MMarsland/Augmented-Reality-Laparoscopic-Surgery-Trainer/images/blender-program.png

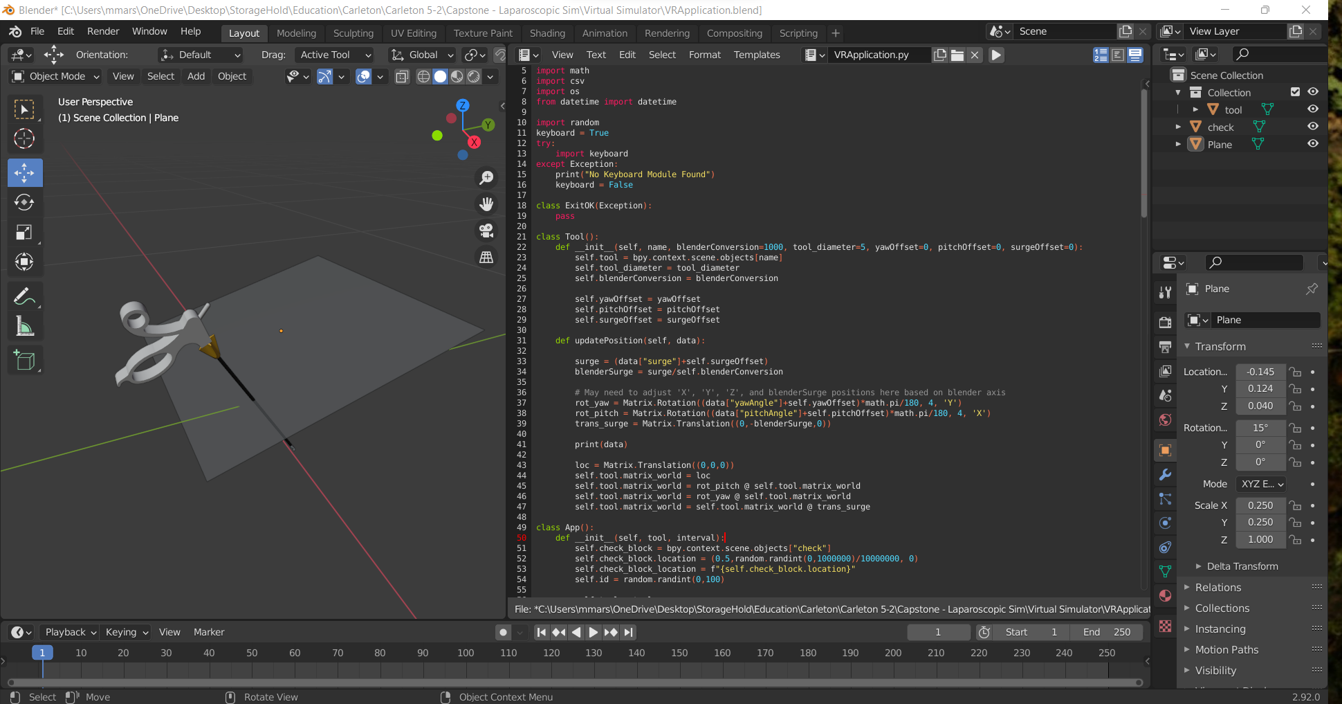
images/blender-program.png
