MMarsland/Augmented-Reality-Laparoscopic-Surgery-Trainer/images/graphs.png

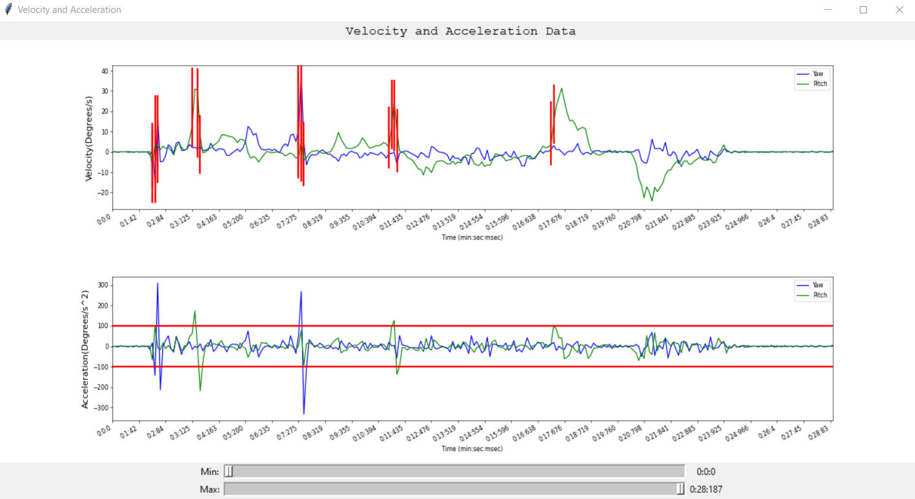
images/graphs.png
