MMarsland/Augmented-Reality-Laparoscopic-Surgery-Trainer/images/inside.jpg

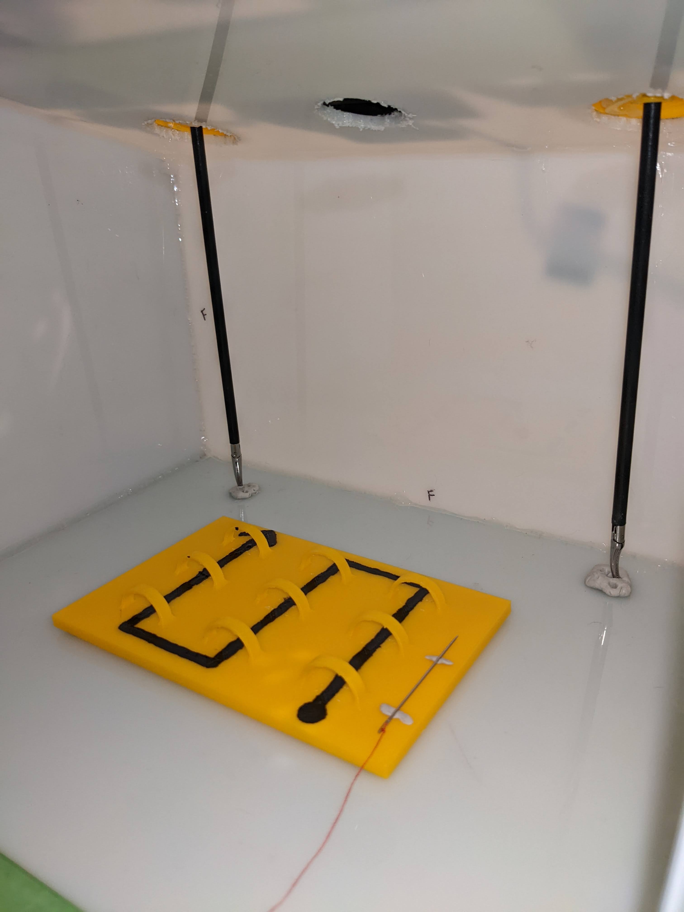
images/inside.jpg
