MMarsland/Augmented-Reality-Laparoscopic-Surgery-Trainer/images/model.png

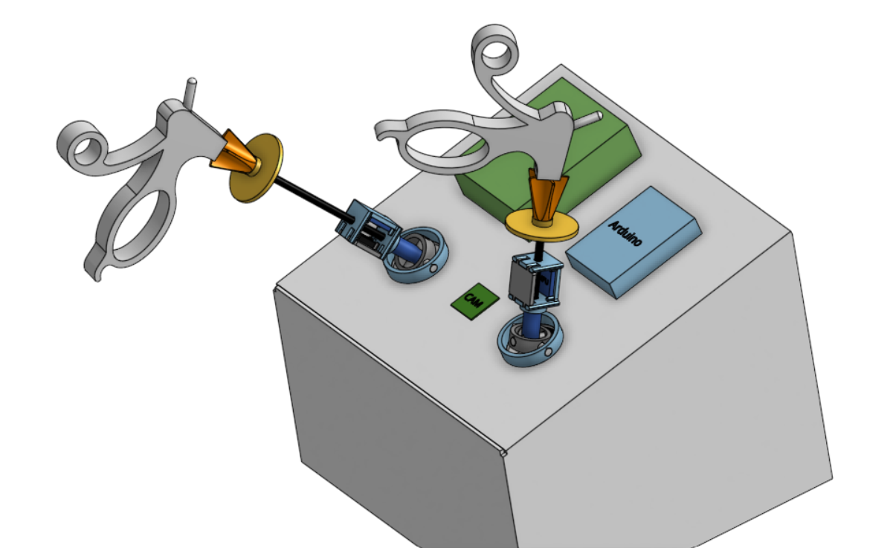
images/model.png
