MMarsland/Augmented-Reality-Laparoscopic-Surgery-Trainer/images/program-running.png

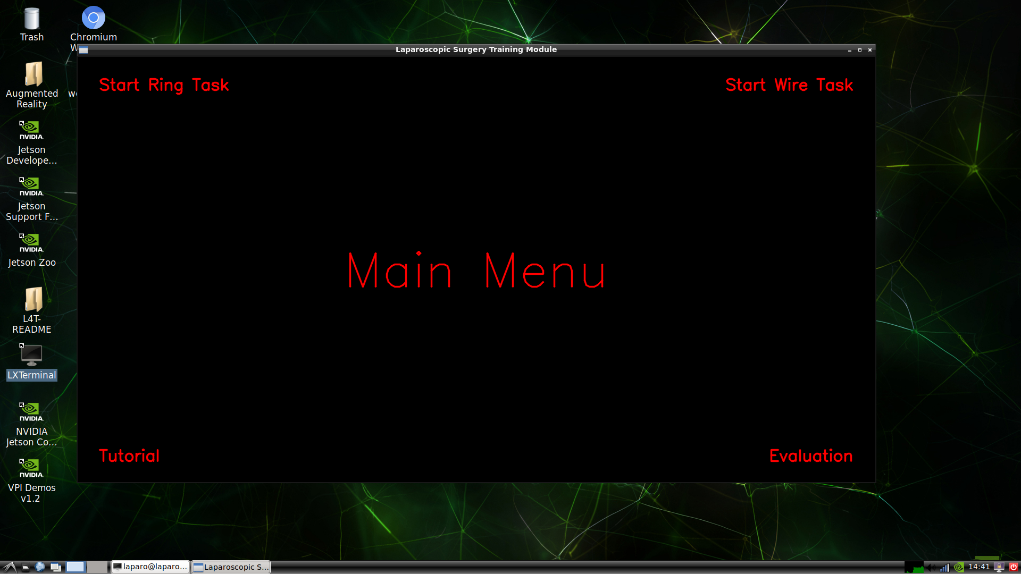
images/program-running.png
