MMarsland/Augmented-Reality-Laparoscopic-Surgery-Trainer/images/running-apparatus.jpg

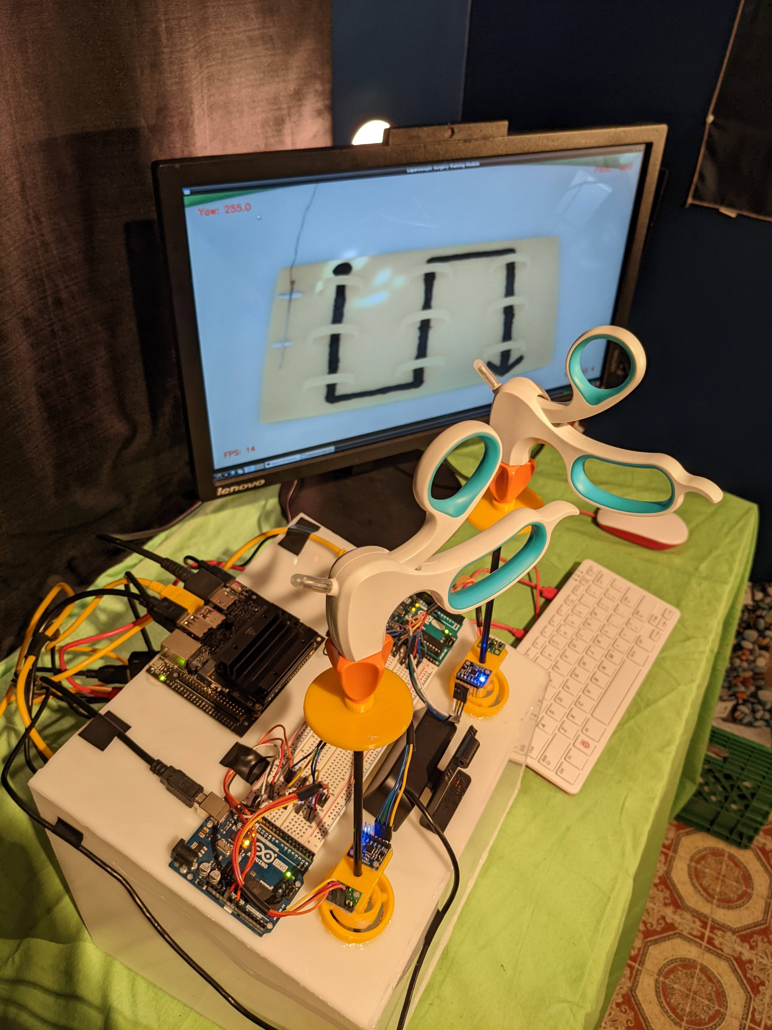
images/running-apparatus.jpg
