MMarsland/Augmented-Reality-Laparoscopic-Surgery-Trainer/images/side-view.jpg

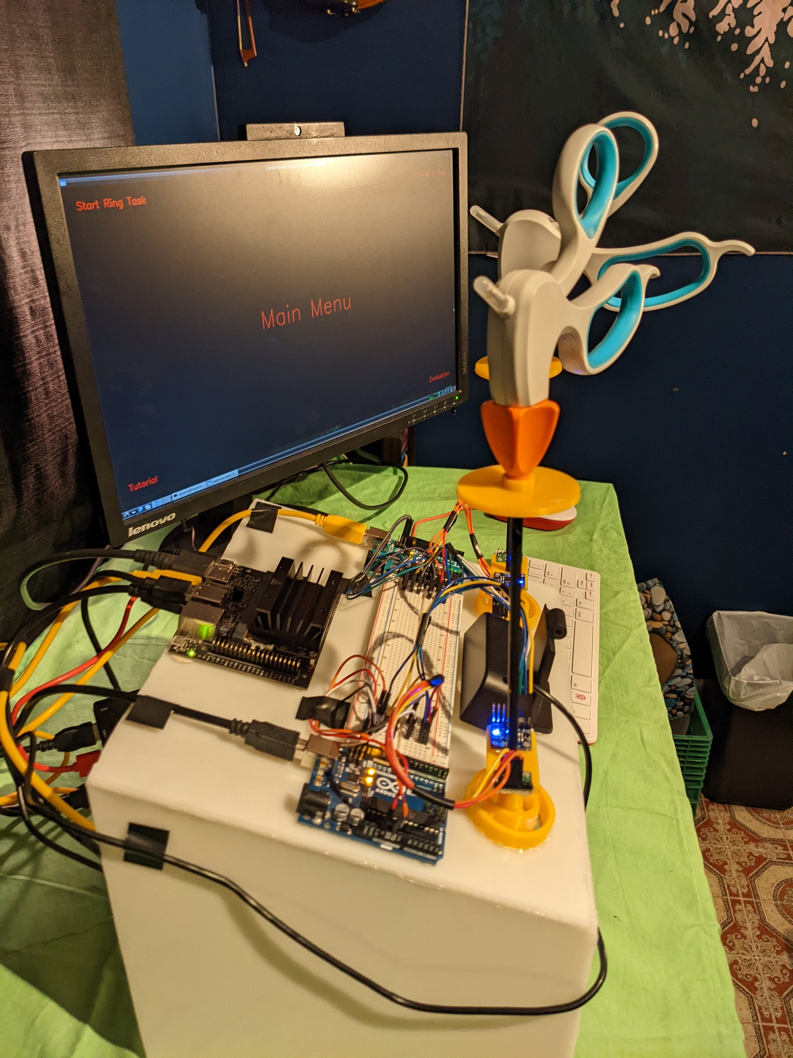
images/side-view.jpg
