MMarsland/Augmented-Reality-Laparoscopic-Surgery-Trainer/images/components.jpg

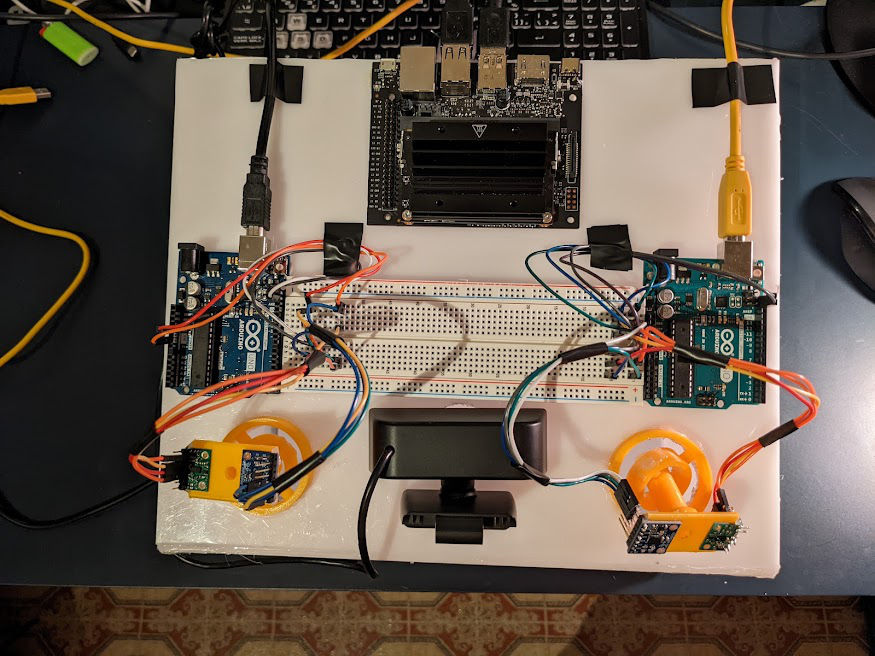
images/components.jpg
