MMarsland/Augmented-Reality-Laparoscopic-Surgery-Trainer/(list of files, cad)

Other CAD files:
virtual-simulator/VRApplication.blend
