MMarsland/Augmented-Reality-Laparoscopic-Surgery-Trainer/images/wiring.jpg

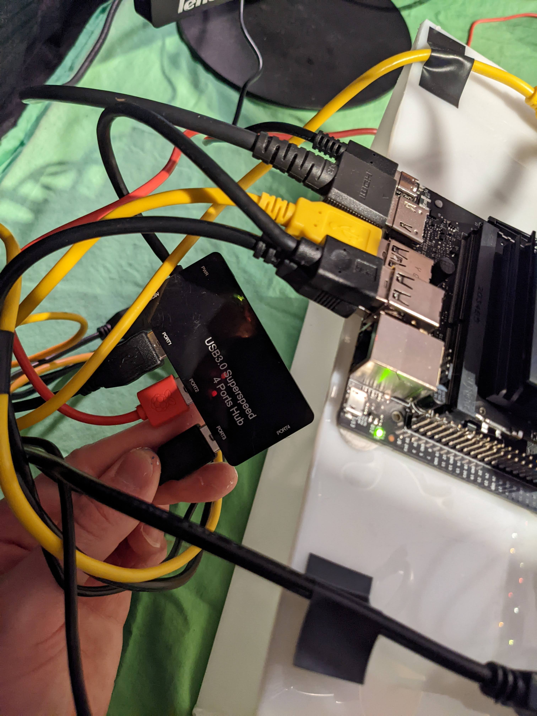
images/wiring.jpg
