MMarsland/Augmented-Reality-Laparoscopic-Surgery-Trainer/augmented-reality/color_calibration.txt

black-179,255,105-0,0,0
red1-179,193,168-3,187,164
red2-180,255,255-8,119,43
yellow-35,255,255-25,50,70
green-80,255,255-40,50,70
brown-20,255,200-10,100,20
white-180,255,255-0,0,231
blue-128,255,255-95,50,70
