MMarsland/Augmented-Reality-Laparoscopic-Surgery-Trainer/(commit log)

2022-04-06 feat: Rearrange Repo
    [sampleData.csv]
2022-04-22 feat: Update Initial Content
    [VRApplication.blend, mpuExampleData.csv, pmwExampleData.csv, sampleData.csv]
2022-04-26 fix: Fix Analyzer Code
    [analyzer.py]
